suvom027/Smart-Glove-for-Sign-Language-Translation/Picture/ruv.png

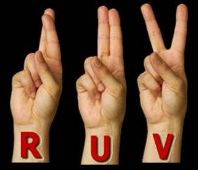
Picture/ruv.png
