suvom027/Smart-Glove-for-Sign-Language-Translation/Picture/full.jpg

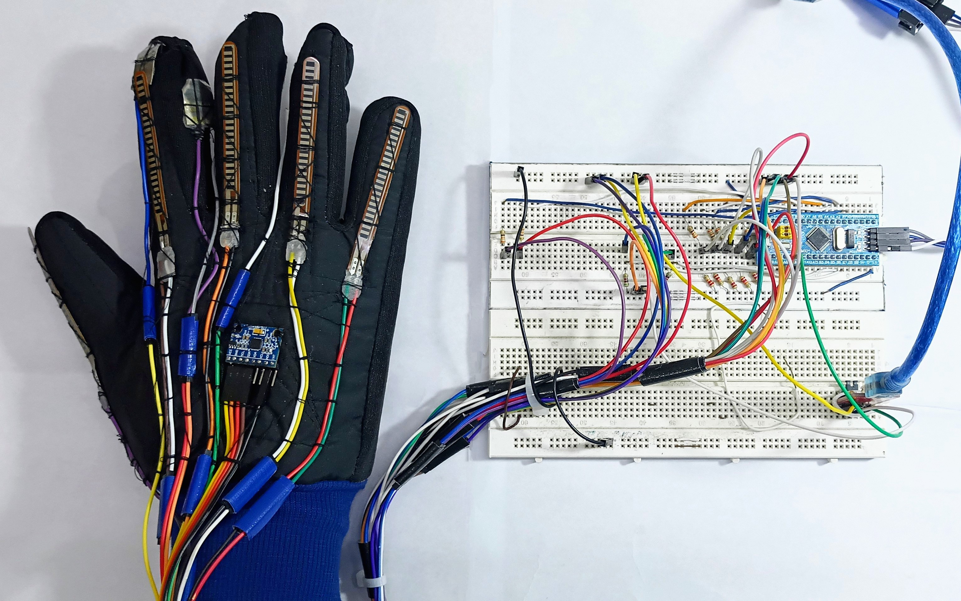
Picture/full.jpg
