suvom027/Smart-Glove-for-Sign-Language-Translation/STM32CubeIDE & Python/STM32CubeIDE & py Code.pdf

Smart Glove for Sign Language Translation

I have uploaded the STM32Cube IDE code for our Smart Glove for Sign Language Translation project. However, I do not share this code publicly. If you are interested in accessing our code, please feel free to send me an email at the following address:

Email Address: skarmakar221027@bseee.uiu.ac.bd

Once I receive your request, I will provide access to the link. Below is the Google Drive link where the code is stored:
https://drive.google.com/drive/folders/1lONdIx9QjWWD4NpTNTNKHwWhy45e0KGr?usp=drive_link (https://drive.google.com/drive/folders/1lONdIx9QjWWD4NpTNTNKHwWhy45e0KGr?usp=drive_link)

Thank you for your interest in our project.
