suvom027/Smart-Glove-for-Sign-Language-Translation/Picture/a.jpg

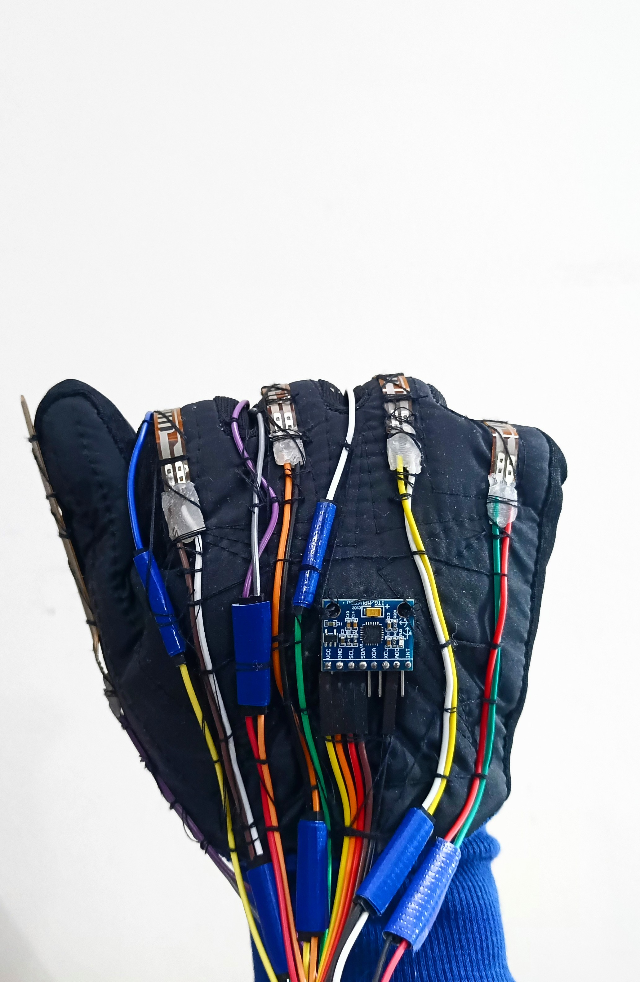
Picture/a.jpg
