suvom027/Smart-Glove-for-Sign-Language-Translation/Picture/b.jpg

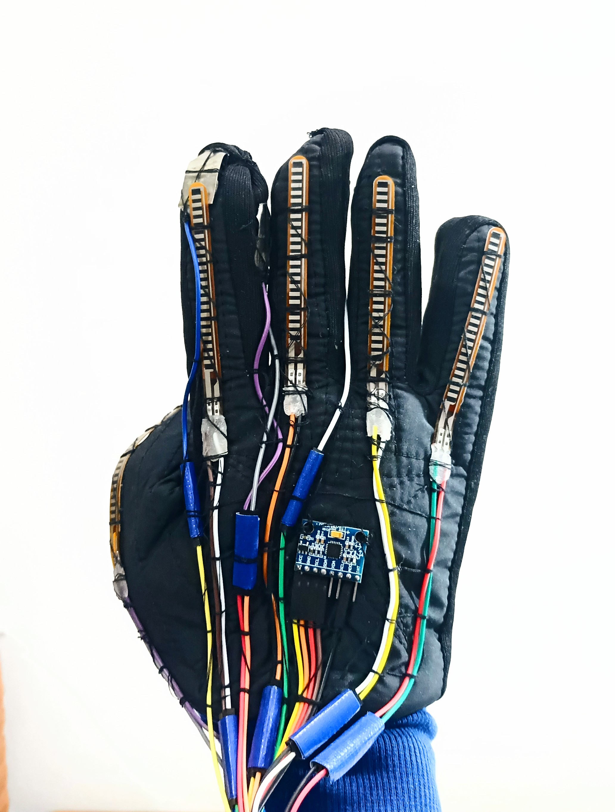
Picture/b.jpg
