suvom027/Smart-Glove-for-Sign-Language-Translation/Picture/chart.png

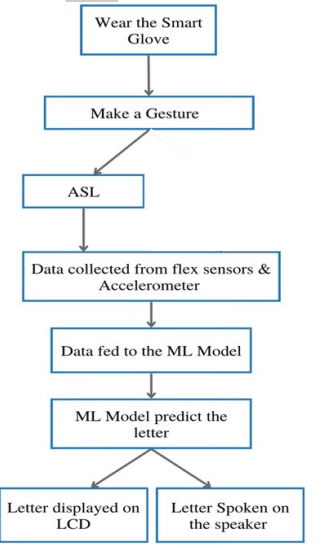
Picture/chart.png
