suvom027/Smart-Glove-for-Sign-Language-Translation/Picture/flow.png

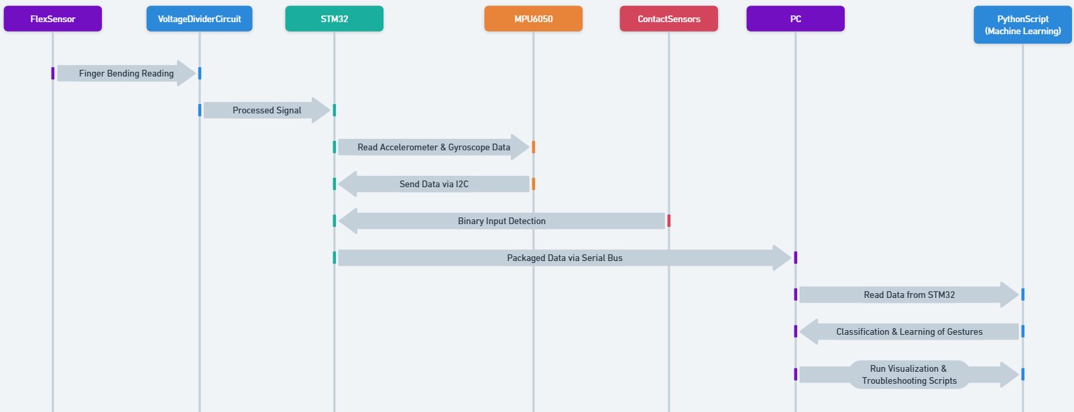
Picture/flow.png
