suvom027/Smart-Glove-for-Sign-Language-Translation/Picture/L.jpg

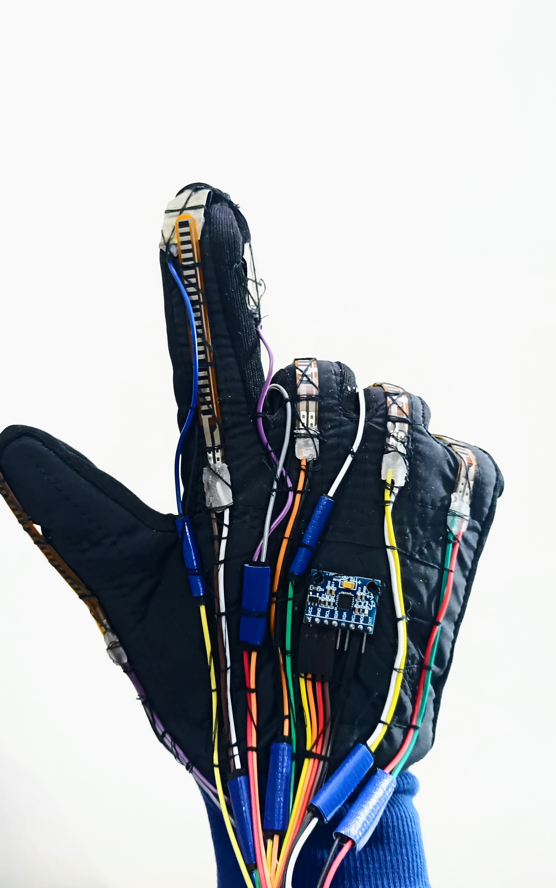
Picture/L.jpg
