suvom027/Smart-Glove-for-Sign-Language-Translation/Picture/v.jpg

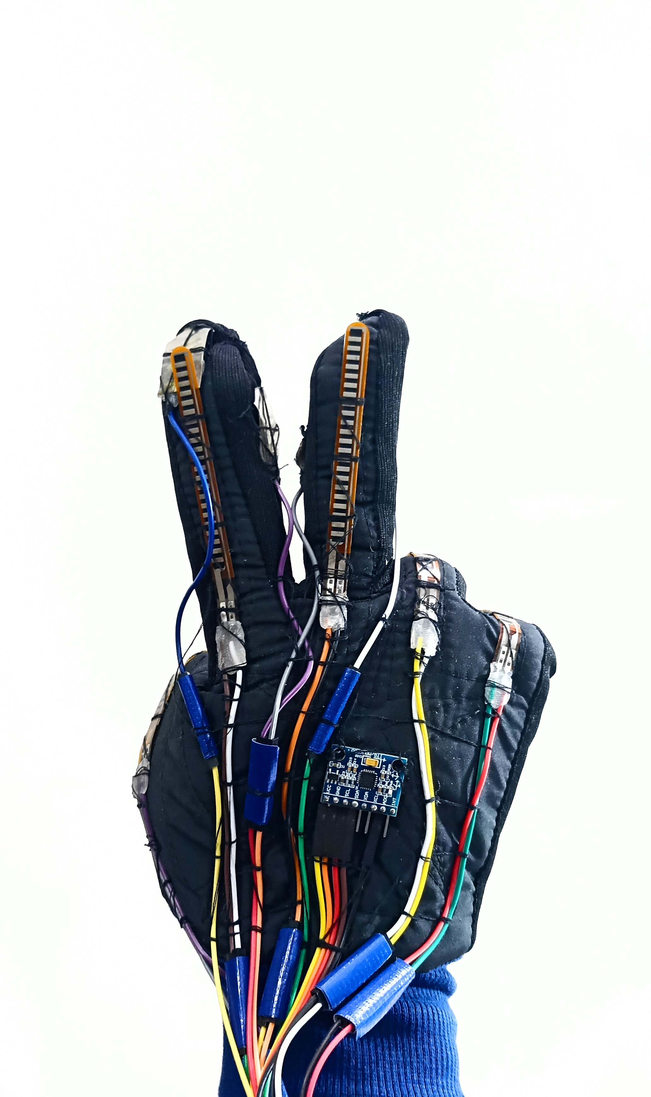
Picture/v.jpg
