suvom027/Smart-Glove-for-Sign-Language-Translation/(list of files, drawings)

Other design files:
Schematic/c1.ms14
Schematic/c2.ms14
Schematic/c3.ms14
